furrtek/PrecIR/hardware/esl_blaster/eslblaster_b_schematic.png

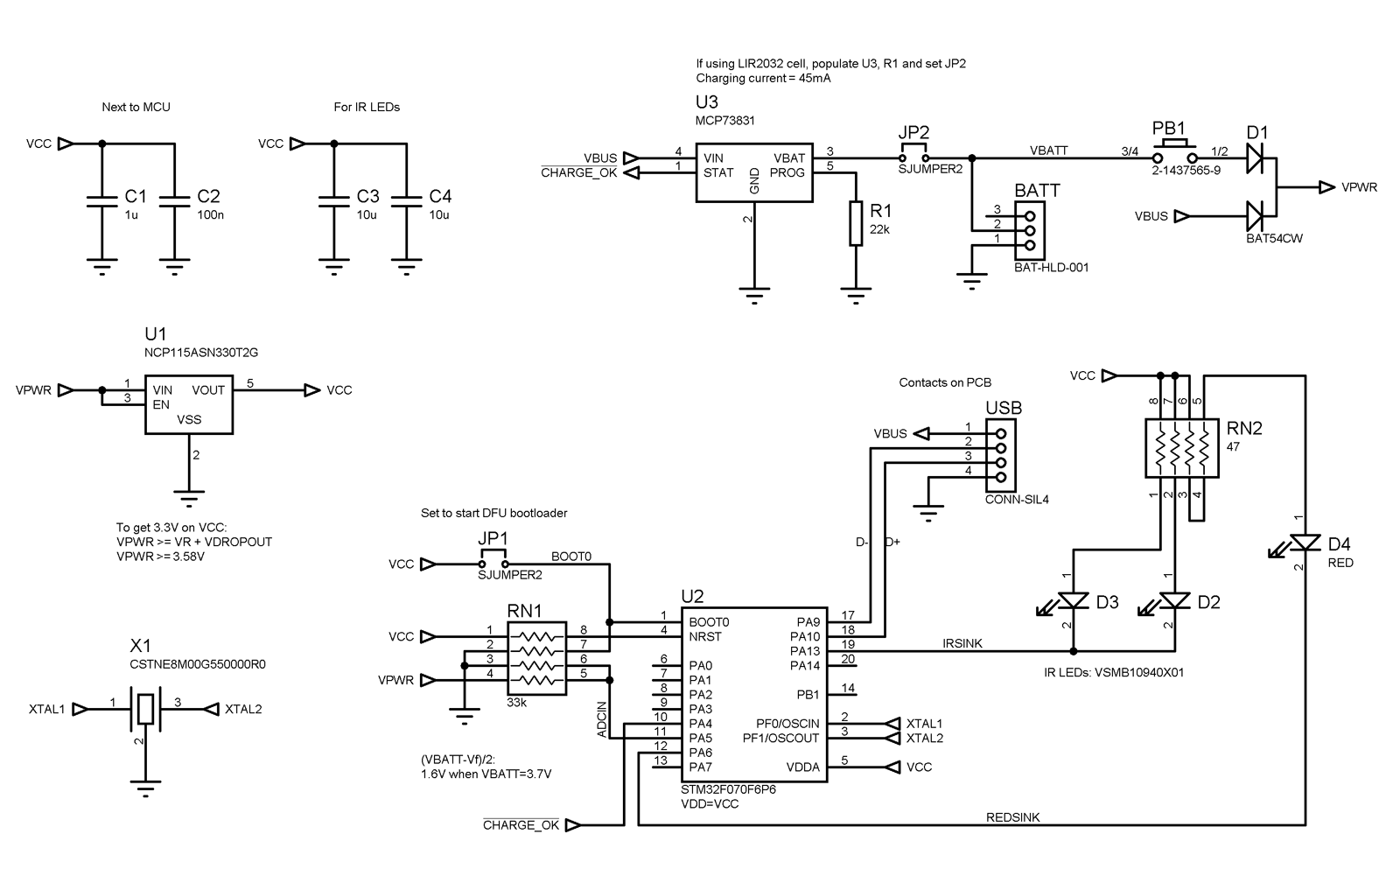
hardware/esl_blaster/eslblaster_b_schematic.png
