furrtek/PrecIR/images/152bwr.png

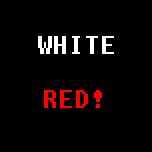
images/152bwr.png
