furrtek/PrecIR/hardware/esl_blaster/Enclosure/eslblaster_b_shell_top.STL

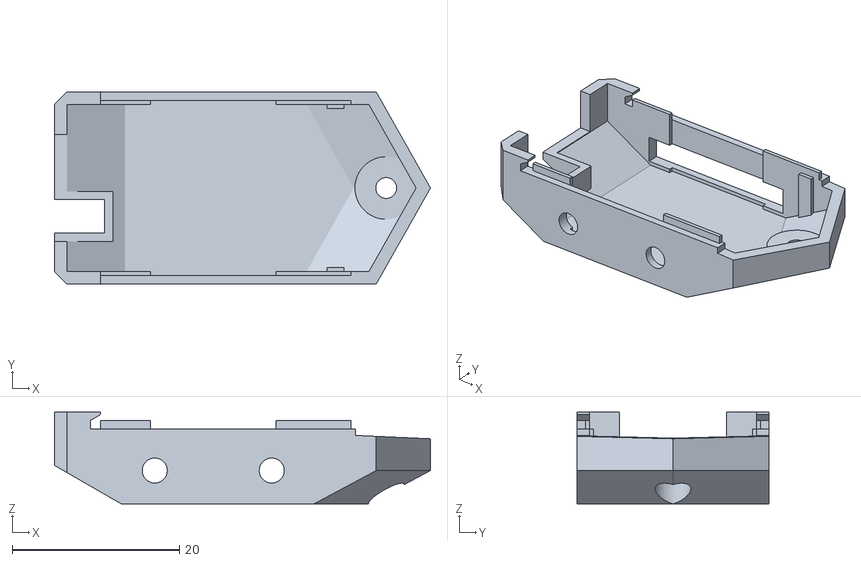
[picture p7: CAD file, 2023-08-06]
hardware/esl_blaster/Enclosure/eslblaster_b_shell_top.STL
45.0 x 23.0 x 11.0
