furrtek/PrecIR/hardware/esl_blaster/Enclosure/eslblaster_b_shell_bot.STL

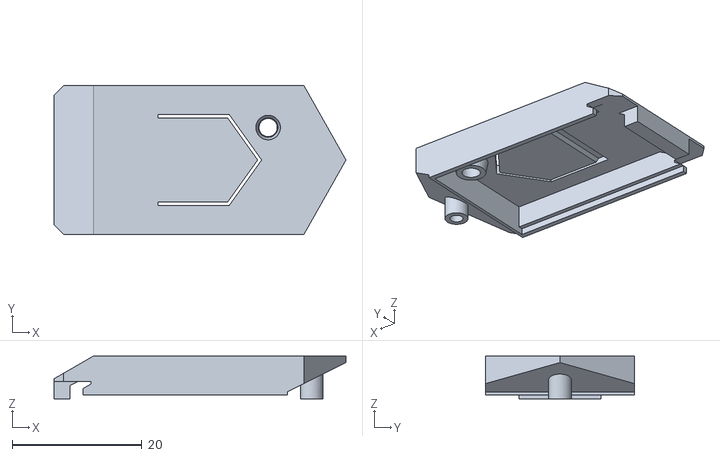
[picture p8: CAD file, 2023-08-06]
hardware/esl_blaster/Enclosure/eslblaster_b_shell_bot.STL
45.0 x 23.0 x 6.60
