furrtek/PrecIR/(threads)

Thread 3 (2020-06-21):

Gherber Design file?

msoffice95, 2020-06-21:
Any chance of a gherber file to get the PCB printed I would like to send to a YouTube tech reviewer (EEVBlog) all credit would be given I would just assemble it

Closed 2020-06-24.

Thread 5 (2021-03-25):

Barcode format?

evm-sec, 2021-03-25:
Can you explain (maybe with an image) how to pull the "17-digit barcode string" from a label device?  I recently got an HD150 model, the barcode on the screen is in the format 5-2 2-4-4-2-4 (# of digits).  The barcode on the back has a 17 digit barcode starting with "A" - although I assume it's probably the barcode on the front.  I got an ESL Blaster and tried it with the 17-digit barcode string on the back, but no luck.  Full disclosure: I'm on Linux and had to modify tx.py to search for /dev/ttyACM* instead of COM*, but it appeared to work after that.

furrtek, 2021-03-26:
The barcode from which the label ID is extracted is indeed the one on the back: http://furrtek.free.fr/noclass/esl/eslbarcode.png
Does the ESL Blaster's red LED turn on ?

evm-apl, 2021-03-26:
Yeah, the red LED came on on the ESL Blaster, although I saw no response from the HD150 tag.  I tried to hold it close to the Blaster and tried it from different angles.  Didn't see anything response or change on the HD150.  I didn't modify the ESL Blaster in any way, it's running whatever firmware you shipped it with. :-)

Here's the output - I double and triple checked that the barcode string matches the string immediately below the barcode on the back.

~/Pricer/PrecIR/tools_python$ sudo python2 img2dm.py 0 foo.png A4108261934813544 0
Found ESL Blaster on /dev/ttyACM0
Compressing 19902 pixels...
Compression ratio: 52.1%
Generating 60 data frames...
Transmitting frame 1/63, length 34, repeated 400 times.
Transmitting frame 2/63, length 34, repeated 1 times.
Transmitting frame 3/63, length 34, repeated 1 times.
Transmitting frame 4/63, length 34, repeated 1 times.
Transmitting frame 5/63, length 34, repeated 1 times.
Transmitting frame 6/63, length 34, repeated 1 times.
Transmitting frame 7/63, length 34, repeated 1 times.
Transmitting frame 8/63, length 34, repeated 1 times.
Transmitting frame 9/63, length 34, repeated 1 times.
Transmitting frame 10/63, length 34, repeated 1 times.
Transmitting frame 11/63, length 34, repeated 1 times.
Transmitting frame 12/63, length 34, repeated 1 times.
Transmitting frame 13/63, length 34, repeated 1 times.
Transmitting frame 14/63, length 34, repeated 1 times.
Transmitting frame 15/63, length 34, repeated 1 times.
Transmitting frame 16/63, length 34, repeated 1 times.
Transmitting frame 17/63, length 34, repeated 1 times.
Transmitting frame 18/63, length 34, repeated 1 times.
Transmitting frame 19/63, length 34, repeated 1 times.
Transmitting frame 20/63, length 34, repeated 1 times.
Transmitting frame 21/63, length 34, repeated 1 times.
Transmitting frame 22/63, length 34, repeated 1 times.
Transmitting frame 23/63, length 34, repeated 1 times.
Transmitting frame 24/63, length 34, repeated 1 times.
Transmitting frame 25/63, length 34, repeated 1 times.
Transmitting frame 26/63, length 34, repeated 1 times.
Transmitting frame 27/63, length 34, repeated 1 times.
Transmitting frame 28/63, length 34, repeated 1 times.
Transmitting frame 29/63, length 34, repeated 1 times.
Transmitting frame 30/63, length 34, repeated 1 times.
Transmitting frame 31/63, length 34, repeated 1 times.
Transmitting frame 32/63, length 34, repeated 1 times.
Transmitting frame 33/63, length 34, repeated 1 times.
Transmitting frame 34/63, length 34, repeated 1 times.
Transmitting frame 35/63, length 34, repeated 1 times.
Transmitting frame 36/63, length 34, repeated 1 times.
Transmitting frame 37/63, length 34, repeated 1 times.
Transmitting frame 38/63, length 34, repeated 1 times.
Transmitting frame 39/63, length 34, repeated 1 times.
Transmitting frame 40/63, length 34, repeated 1 times.
Transmitting frame 41/63, length 34, repeated 1 times.
Transmitting frame 42/63, length 34, repeated 1 times.
Transmitting frame 43/63, length 34, repeated 1 times.
Transmitting frame 44/63, length 34, repeated 1 times.
Transmitting frame 45/63, length 34, repeated 1 times.
Transmitting frame 46/63, length 34, repeated 1 times.
Transmitting frame 47/63, length 34, repeated 1 times.
Transmitting frame 48/63, length 34, repeated 1 times.
Transmitting frame 49/63, length 34, repeated 1 times.
Transmitting frame 50/63, length 34, repeated 1 times.
Transmitting frame 51/63, length 34, repeated 1 times.
Transmitting frame 52/63, length 34, repeated 1 times.
Transmitting frame 53/63, length 34, repeated 1 times.
Transmitting frame 54/63, length 34, repeated 1 times.
Transmitting frame 55/63, length 34, repeated 1 times.
Transmitting frame 56/63, length 34, repeated 1 times.
Transmitting frame 57/63, length 34, repeated 1 times.
Transmitting frame 58/63, length 34, repeated 1 times.
Transmitting frame 59/63, length 34, repeated 1 times.
Transmitting frame 60/63, length 34, repeated 1 times.
Transmitting frame 61/63, length 34, repeated 1 times.
Transmitting frame 62/63, length 34, repeated 1 times.
Transmitting frame 63/63, length 34, repeated 1 times.
Done. Please allow a few seconds for the ESL to refresh.

Closed 2023-08-06.

Thread 6 (2021-08-14):

ESP32 or ESP8266 Support?

ZL1LAC, 2021-08-14:
Can the code run on an esp32 or an ESP8226 instead of an attiny?

furrtek, 2021-08-15:
I have no experience with ESP modules but given their power and speed, that's certainly possible.

Thread 8 (2023-05-28):

Information/Feature Idea

mmiller7, 2023-05-28:
I understand from the ReadMe that the data-rates are unusually high so I don't know the feasibility of this idea, but thought I would ask.

The [Flipper Zero has an IR emitter](https://docs.flipperzero.one/infrared) and can support custom made applications as well as [GPIO output signals](https://docs.flipperzero.one/gpio-and-modules).  Have you explored if this could be ported to run on that device either with built-in IR emitter or a simple GPIO addon, allowing with a dynamic input of the required serial/ID to select from more than one "picture" to send to a different tag "on-demand"?

furrtek, 2023-05-28:
The Flipper Zero is entirely capable of sending IR frames to these price tags without any add-on.

Unfortunately, several FZ owners had the great idea to beg / try to pull me into writing such an app, effectively annoying the life out of me. Some months ago, I got dragged into a dedicated Telegram group and spent several hours in it trying to steer people in the right direction, but in the end not a single line of code was written. Since noone was going anywhere and since I wasn't going to give into the begging, someone just decided to delete the group overnight. Total waste of time.

The simple fact that these people are putting more energy into making others work instead of doing the work theirselves, is honestly pitiful. I'm sorry but I will -NOT- work for free for consumer-minded people.

mmiller7, 2023-05-29:
Fair enough!  Its interesting to hear you got far enough to verify it is capable of sending the signals.  Maybe some day if I find time to learn coding for Flipper apps I'll explore how hard it would be to port over, but for now I can relate with so many other things competing for my time as well.

Closing the ticket as that seems the reasonable thing to do at this point.  Cheers!

furrtek, 2023-05-29:
Will add the info (minus my uncalled-for criticism) in the readme file.

Closed 2023-05-29.

Thread 17 (2024-02-20):

program.bat file is missing for FW3.

ramhen0, 2024-02-20:
Is it going to be same as FW2? Also, I wondering how does the ESL Blaster connects with the app?

furrtek, 2024-02-20:
Yes it's the same, just replace `ESLBlaster02.bin` with `ESLBlaster02.bin`.
The ESL Blaster connects via USB to the Android app, it's handled as a virtual serial port.

ramhen0, 2024-02-20:
Thank you for prompt response. I am guessing you meant to say ESLBlaster02.bin with ESLBlaster03.bin?

Also how would it function on “field”? I am guessing the battery can be use to power it and then app on my phone connects via virtual serial port?

I just bought one :)

Sent from my iPhone

On Feb 19, 2024, at 10:45 PM, Furrtek ***@***.***> wrote:

Yes it's the same, just replace ESLBlaster02.bin with ESLBlaster02.bin.
The ESL Blaster connects via USB to the Android app, it's handled as a virtual serial port.

—
Reply to this email directly, view it on GitHub<https://github.com/furrtek/PrecIR/issues/17#issuecomment-1953440148>, or unsubscribe<https://github.com/notifications/unsubscribe-auth/A2DZSQOB4H6IWE2NNZCMYELYUQL6BAVCNFSM6AAAAABDQM5SSWVHI2DSMVQWIX3LMV43OSLTON2WKQ3PNVWWK3TUHMYTSNJTGQ2DAMJUHA>.
You are receiving this because you authored the thread.Message ID: ***@***.***>

ramhen0, 2024-03-15:
After using the app, there are some of my observations.
1) It will help if it was manually added pixel length and width rather than slider. As a requirement, the size is supposed to be multiple of 8, the sliding part is repeated several times before it lands on the multiple of 8 value. Without selecting the multiple of 8, the image is not transferred.
2) I have been able to transfer 120*120 px image. Anything more than that is not being send. Also, the image occupies the left side of the tag. I think max length for px is possibly 120~144? Width would be slight twice the size. (I have a medium sized tag.)
3) If there were instructions on how to use the app itself, it will make the process smooth.

Thank you for the work!

Thread 19 (2024-04-23):

Android app does not detect the ESL blaster

kilo3421, 2024-04-23:
With the latest app version, the blaster still reads "Disconnected" and the TX is greyed out.

On the screenshot, you can see the red light in the middle of the 5.

(Included usb-A to usb-C cable)
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

furrtek, 2024-04-24:
Hello.
Do you have OTG enabled on your phone ?
It's sometimes disabled by default, or after 15 minutes without USB activity.

kilo3421, 2024-04-24:
OTG is enabled by default, i did test with an USB device.
I don't think ive reached the 15 min afk.
Also, to mention, i have an S20 FE 5G

Thanks.

kilo3421, 2024-05-07:
After receiving an good cable, the cable provided with the Tindie order is faulty. The phone does connect to the ESL blaster.

Closed 2024-05-07.

Thread 21 (2024-10-29):

PriceSpy

tekollt, 2024-10-29:
@furrtek  have you tried the opposite way around, not updating the ESL`s but reading out the data?

Considering that the IR is not bi-directional i assume that there is a general broadcast from the TRXs and if it has the label`s id - it will take that information and update it self.

It would be interesting to see if we can read this transmit, have you tried such a thing in your lab or setup?

furrtek, 2024-11-04:
I haven't tried it, but I can't imagine what would prevent that from working.
To receive the weak ESL ack signals, the TRXs use shaped reflectors and a rather complex circuit for very high gain amplification.
Receiving the downlink signal however should be easier given the power at which updates are transmitted.
Fast photodiode -> bandpass -> AGC -> AM demod / carrier detect -> microcontroller might be enough.

Modern installations have ESL roaming detection, allowing updates to be broadcast only by TRXs located around the last known position of an ESL. If there's no ack from it, then the update is broadcast again store-wide this time to detect where the tag has moved. This might make complete store updates logging difficult with only one spying device.
