furrtek/PrecIR/hardware/esl_blaster/FW01/ESLBlaster.ioc

Mcu.UserName=STM32F070F6Px
PA11.Signal=USB_DM
PA12.Signal=USB_DP
PF0-OSC_IN.Signal=RCC_OSC_IN
PF1-OSC_OUT.Signal=RCC_OSC_OUT
