furrtek/PrecIR/(commit log)

2018-09-21 IR serial transmitter source & schematic
2018-09-26 Added DM image frame generator script
2018-09-29 Added serial comm. for transmitter Data size bugfix Example bitmaps
    [img2dm.py]
2018-09-29 Removed null byte serial workaround PNGized sample images
    [img2dm.py, ir_tx_serial.c]
2018-09-30 Raw frame utility Moved ESL protocol stuff to pr.py
2019-06-10 Serial for Python3 doesn't like writing strings
    [tx.py]
2019-06-14 HW Rev. B update USB/battery boot detection Battery charge detection VCP repeats field is now 16-bit Flash programming for IR remote data PWM for red LED Updated clock settings for 8MHz oscillator Ad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
    [flashtest.py, gpio.c, img2dm.py, main.c, pr.py, tx.py]
2019-06-24 Added ESL Blaster schematic and purchase link
2019-07-06 Added ESL type parameter for rawcmd Increased serial tx timeout Added fuse values for serial tx (thanks F4GMU !)
2019-08-10 Bugfix: setsegs.py bitmap length
    [setsegs.py]
2022-11-19 Added linux USB serial port probe
2022-12-22 Silly luma threshold bug :(
    [img2dm.py]
2022-12-23 Better PP16 timings
    Coin cell charge detection bugfix
    ESL Blaster FW version detection
    Updated flashtest.py to write nasty frames (DM show debug info permanently)
    [flashtest.py, main.c, rawcmd.py, tx.py]
2022-12-24 Linux ESL Blaster detection bugfix (thanks Sezk'in)
    [tx.py]
2023-08-06 Added ESL Blaster enclosure files
    [eslblaster_b_shell_bot.STL, eslblaster_b_shell_top.STL]
2023-09-04 PriceHax v2.1
    Feature: Option to disable dithering (faster transmit)
    Feature: Use PP16 protocol (faster transmit)
    Bugfix: BWR conversion fixed
    Bugfix: Some particular image sizes were not accepted by ESLs
    Bugfix: Cam preview resume
    Better thresholds for color detection
    Adjusted repeat and delay transmit parameters
    Enable/disable scaling slider depending on original image size
    Cleanups, removed some logging, Lambda-ized
    [MainActivity.java]
2024-04-01 Silence warning; Fix port selection on OS X
    [img2dm.py, tx.py]
